JulienGuitter/KeyPass/composant/listcomposant.ods

Liste composant
Name | value | Quantity | price /u | price | site
Condensateur | 2.2µF | 1 | 0.10 € | 0.097 | rs | -
 | 1µF | 4 | 0.04 € | 0.164 | rs | - | total | 58.442
 | 4.7µF | 2 | 0.18 € | 0.36 | farnell | -
 | 100nF | 5 | 0.01 € | 0.055 | rs | -
 | 33µF | 1 | 0.97 € | 0.97 | farnell | -
 | 10µF | 1 | 0.09 € | 0.09 | farnell | -
 | 0.47µF | 1 | 0.07 € | 0.07 | farnell | -
 | 12pF | 2 | 0.05 € | 0.1 | farnell | -
Resistance | 820k | 1 | 0.06 € | 0.058 | rs | -
 | 2k | 2 | 0.03 € | 0.054 | rs | -
Crystal quartz | 8MHz | 1 | 0.48 € | 0.482 | rs | -
Button |  | 2 | 0.39 € | 0.784 | rs | -
Connecteur FPC |  | 1 | 1.15 € | 1.148 | rs | -
Oled screen |  | 1 | 12.32 € | 12.32 | rs | -
Flash memory |  | 1 | 2.42 € | 2.42 | rs | -
STM32F103RBT6 |  | 1 | 8 € | 8 |  | -
Regulateur tension |  | 1 | 2.20 € | 2.2 | farnell | -
Finger Print capteur |  | 1 | 27.50 € | 27.5 | gotronic | -
connecteur usb |  | 1 | 1.57 € | 1.57 | farnell | -
