JulienGuitter/KeyPass/(list of files, drawings)

Other design files:
pcb/Passkey/mainSheet.SchDoc
pcb/Passkey/Passkey.PrjPcb
pcb/Passkey/pcb.PcbDoc
