JulienGuitter/KeyPass/Programme/Core/Src/main.c

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
/* Includes ------------------------------------------------------------------*/
#include "main.h"
#include "adc.h"
#include "i2c.h"
#include "spi.h"
#include "usart.h"
#include "gpio.h"

/* USER CODE BEGIN Includes */
#include "w25qxx.h"
#include "DFRobot_ID809.h"
#include "lcd_i2c.h"
#include "password.h"
/* USER CODE END Includes */


/* USER CODE BEGIN PV */
extern UART_HandleTypeDef huart1;

uint8_t buffer1[20];
uint8_t buffer2[100] = {0};
uint8_t codeState = e_INIT;
bool toSingleLoad = true;
char passwordStr[100] = {0};
uint8_t indexFlash[1] = {0};
uint8_t idButton = 0;
/* USER CODE END PV */

void SystemClock_Config(void);
/**
  * @brief  The application entry point.
  * @retval int
  */
int main(void)
{
  /* MCU Configuration--------------------------------------------------------*/

  /* Reset of all peripherals, Initializes the Flash interface and the Systick. */
  HAL_Init();

  /* USER CODE BEGIN Init */
  HAL_Delay(100);
  /* USER CODE END Init */

  /* Configure the system clock */
  SystemClock_Config();

  /* Initialize all configured peripherals */
  MX_GPIO_Init();
  MX_USB_PCD_Init();
  MX_I2C1_Init();
  MX_USART1_UART_Init();
  MX_SPI2_Init();
  MX_ADC1_Init();
  /* USER CODE BEGIN 2 */

  DFRobot_ID809_Init();
  MX_USB_DEVICE_Init();
  // Calibrate The ADC On Power-Up For Better Accuracy
  HAL_ADCEx_Calibration_Start(&hadc1);

  HAL_Delay(100);
  lcd_init ();
  lcd_clear ();
  HAL_Delay(100);

  writeOnLCD("      KeyPass", "Loading ...");

  uint8_t *data = "Hello World from USB CDC\n";
  CDC_Transmit(0, data, strlen(data));


  /* --------- differente commande for flash memeorie */
  W25qxx_Init();
  //block 1 for nb of password and fingerprint nb
  HAL_Delay(500);
  DFRobot_ID809_ctrlLED(eKeepsOn, eLEDRed, 0);
  //printf("Start\n");

  while (DFRobot_ID809_isConnected() == false) {
  	DFRobot_ID809_ctrlLED(eBreathing, eLEDWhite, 0);
	HAL_Delay(1000);
  }

  HAL_Delay(50);
  DFRobot_ID809_ctrlLED(eKeepsOn, eLEDGreen, 0);

  HAL_Delay(500);

  codeState = e_MENU;

  /* USER CODE END 2 */

  /* Infinite loop */
  /* USER CODE BEGIN WHILE */
  while (1){
	  /* USER CODE END WHILE */
	  static uint8_t elementInMenu = 0;
	  switch(codeState){
		  case e_MENU:{
			  static char* menuButtons[5] = {"   Load password", "    Add password", "     Add finger", "     Del finger", "   reset password"};
			  if(toSingleLoad){
				  DFRobot_ID809_ctrlLED(eNormalClose, eLEDRed, 0);
				  elementInMenu = 5;
				  toSingleLoad=false;
				  writeOnLCD(menuButtons[idButton],"          ->    ok");
			  }
			  if(readButtonFinger()){
				  toSingleLoad = true;
				  switch(idButton){
				  	  case 0:
				  		codeState = e_PASSWORD;
				  		  break;
				  	  case 1:
				  		codeState = e_ADDPASSWORD;
				  		  break;
				  	  case 2:
				  		codeState = e_ADDFINGER;
				  		  break;
				  	  case 3:
				  		codeState = e_DELFINGER;
				  		  break;
				  	  case 4:
				  		  codeState = e_PASSRESET;
				  		  break;
				  }
				  idButton = 0;
			  }
			  if(readButton2()){
				  toSingleLoad = true;
				  if(idButton == elementInMenu-1){
					  idButton = 0;
				  }else{
					  idButton++;
				  }
			  }
			  break;
		  }
		  case e_PASSWORD:{
			  if(toSingleLoad){
				  W25qxx_ReadBlock(indexFlash, 1, 0, 1);
				  toSingleLoad=false;
				  if(indexFlash[0] > 0){
					  DFRobot_ID809_ctrlLED(eNormalClose, eLEDRed, 0);
					  W25qxx_ReadBlock(buffer1, 2+(idButton*2)+1, 0, 100);
					  writeOnLCD(buffer1,"  menu    ->    ok");
				  }else{
					  writeOnLCD("     No password","    return");
				  }
				  codeState = e_PASSWORD;
			  }
			  if(readButton2()){
				  codeState = e_PASSWORD;
				  if(indexFlash[0] > 0){
					  toSingleLoad = true;
					  if(idButton == indexFlash[0]-1){
						  idButton = 0;
					  }else{
						  idButton++;
					  }
				  }
			  }
			  if(readButtonFinger()){
				  codeState = e_PASSWORD;
				  toSingleLoad = true;
				  if(indexFlash[0] > 0){
					  writeOnLCD("    Check finger","       put it");
					  while(DFRobot_ID809_detectFinger());
					  if(testFingerPrint()){
						  writeOnLCD("    Start writing","      password");
						  W25qxx_ReadBlock(buffer1, 2+(idButton*2)+2, 0, 100);
						  W25qxx_R
						  writePasswordHID(buffer1);
						  writeOnLCD("    Writing done","");
						  codeState = e_MENU;
						  idButton=0;
						  HAL_Delay(1000);
					  }else{
						  writeOnLCD("    Wrong finger","");
					  }
					  HAL_Delay(1000);
				  }
			  }
			  if(readButton1()){
				  codeState = e_MENU;
				  toSingleLoad = true;
				  idButton=0;
			  }
			  break;
		  }
		  case e_ADDPASSWORD:{
			  writeOnLCD("    Check finger","       put it");
			  while(DFRobot_ID809_detectFinger());
			  if(testFingerPrint()){
				  bool _Lettre_, _Number_, _SpeChar_, _Capitals_;

				  HAL_Delay(500);
				  DFRobot_ID809_ctrlLED(eNormalClose, eLEDRed, 0);

				  writeOnLCD("    Has lettre ?","    no       yes");
				  while(!readButton1() && !(_Lettre_ = readButton2()));
				  writeOnLCD("    Has number ?","    no       yes");
				  while(!readButton1() && !(_Number_ = readButton2()));
				  writeOnLCD(" Has special char ?","    no       yes");
				  while(!readButton1() && !(_SpeChar_ = readButton2()));
				  writeOnLCD("   Has capitals ?","    no       yes");
				  while(!readButton1() && !(_Capitals_ = readButton2()));
				  writeOnLCD(" Starting generation","");

				  if(!_Number_ && !_SpeChar_) _Lettre_ = true;

				  generatePassword(passwordStr, 10, _Lettre_, _Number_, _SpeChar_, _Capitals_);

				  uint8_t namePass[21] = "Password  ";

				  W25qxx_ReadBlock(indexFlash, 1, 0, 1);

				  namePass[9] = indexFlash[0]+'0';

				  W25qxx_EraseBlock(2+((indexFlash[0])*2)+1);
				  W25qxx_EraseBlock(2+((indexFlash[0])*2)+2);
				  W25qxx_WriteBlock(namePass, 2+((indexFlash[0])*2)+1, 0, 21);
				  W25qxx_WriteBlock(passwordStr, 2+((indexFlash[0])*2)+2, 0, 100);

				  indexFlash[0]++;
				  W25qxx_EraseBlock(1);
				  W25qxx_WriteBlock(indexFlash, 1, 0, 1);

				  writeOnLCD("  Password has been","      generated");
				  HAL_Delay(1000);

				  codeState = e_MENU;

			  }else{
				  writeOnLCD("    Wrong finger","");
				  HAL_Delay(1000);
				  codeState = e_MENU;
			  }
			  break;
		  }
		  case e_ADDFINGER:{
			  writeOnLCD("  Your going to add","   finger print");
			  HAL_Delay(500);
			  addFingerPrint();
			  HAL_Delay(500);
			  codeState = e_MENU;
			  break;
		  }
		  case e_DELFINGER:{
			  writeOnLCD("Your going to delete", "   finger print");
			  delFingerPrint();
			  resetAllPassword();
			  HAL_Delay(500);
			  codeState = e_MENU;
			  break;
		  }
		  case e_PASSRESET:{
			  writeOnLCD("    Check finger","       put it");
			  while(DFRobot_ID809_detectFinger());
			  if(testFingerPrint()){
				  writeOnLCD("  Password has been","        reset");
				  resetAllPassword();
			  }else{
				  writeOnLCD("    Wrong finger","");
			  }
			  HAL_Delay(1000);
			  codeState = e_MENU;
			  break;
		  }
	  }
    /* USER CODE BEGIN 3 */
  }
  /* USER CODE END 3 */
}

bool readButton2(void)
{
	static bool lastPosBP1 = false;
	bool actualPosBP1 = HAL_GPIO_ReadPin(BP1_GPIO_Port, BP1_Pin);
	if(actualPosBP1 != lastPosBP1){
		lastPosBP1 = actualPosBP1;
		return actualPosBP1;
	}
	return false;
}

bool readButton1(void)
{
	static bool lastPosBP2 = false;
	bool actualPosBP2 = HAL_GPIO_ReadPin(BP2_GPIO_Port, BP2_Pin);
	if(actualPosBP2 != lastPosBP2){
		lastPosBP2 = actualPosBP2;
		return actualPosBP2;
	}
	return false;
}
bool readButtonFinger(void){
	static bool lastPosBP2 = false;
	bool actualPosBP2 = DFRobot_ID809_detectFinger();
	if(actualPosBP2 != lastPosBP2){
		lastPosBP2 = actualPosBP2;
		return actualPosBP2;
	}
	return false;
}

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
