JulienGuitter/KeyPass/Programme/Core/Inc/main.h

#define BP2_Pin GPIO_PIN_14
#define BP2_GPIO_Port GPIOC
#define BP1_Pin GPIO_PIN_15
#define BP1_GPIO_Port GPIOC
#define FLASH_CS_Pin GPIO_PIN_12
#define FLASH_CS_GPIO_Port GPIOB
#define I2C1_RES__Pin GPIO_PIN_5
#define I2C1_RES__GPIO_Port GPIOB
